matiassambrizzi/cnc-embebidos/Doc/Img/Estructura/Escuadras/resultadoFinal.JPG

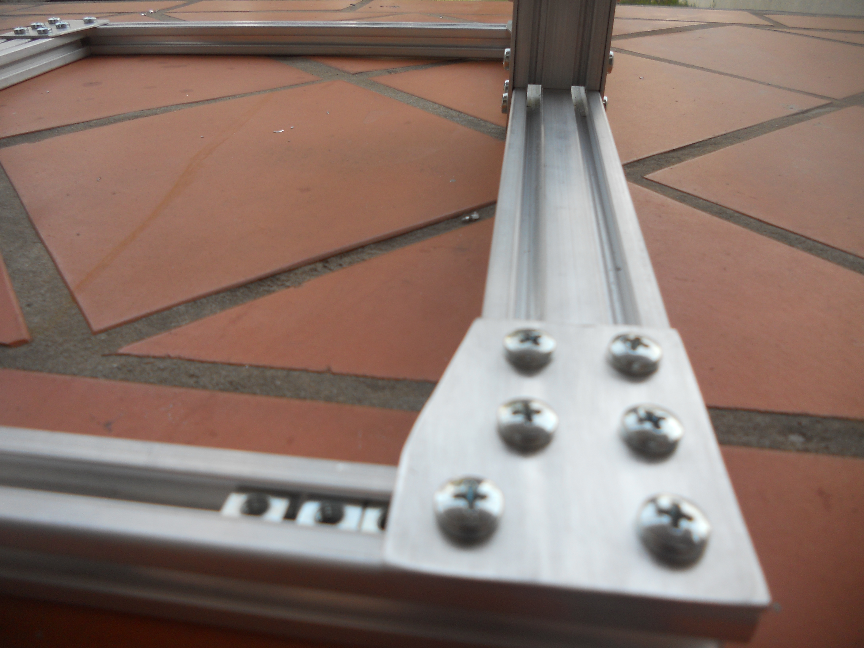
Doc/Img/Estructura/Escuadras/resultadoFinal.JPG
