matiassambrizzi/cnc-embebidos/Doc/Img/Estructura/Escuadras/resultadoFinalLateral.JPG

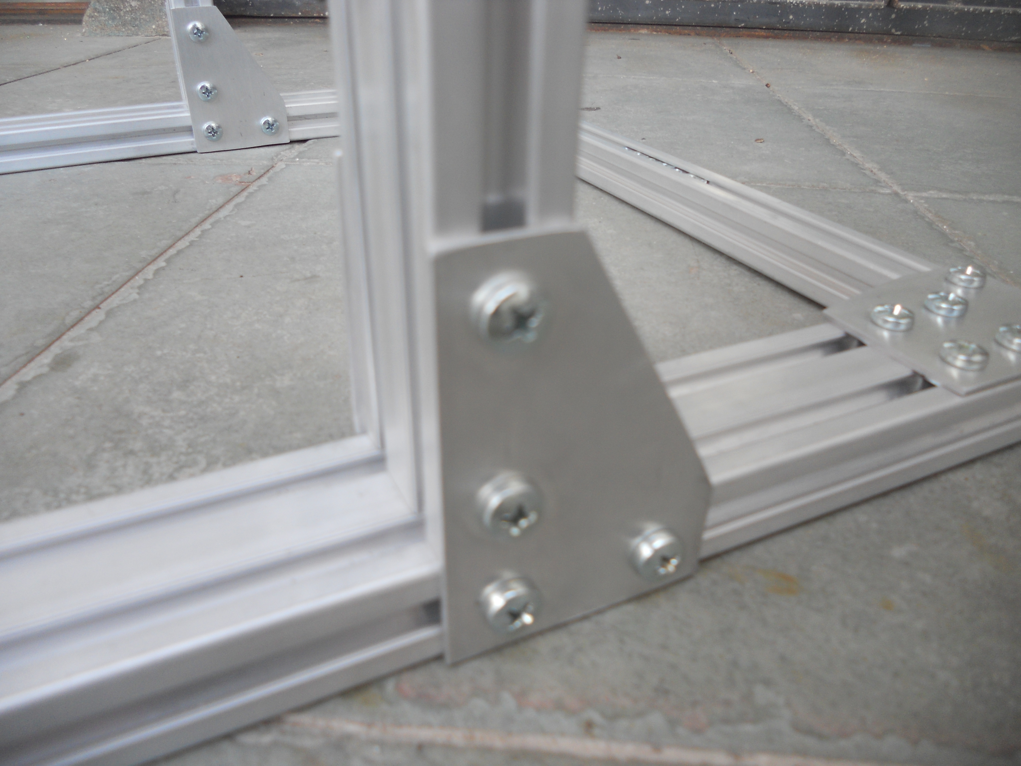
Doc/Img/Estructura/Escuadras/resultadoFinalLateral.JPG
