matiassambrizzi/cnc-embebidos/README.md

# cnc-embebidos
Construcción de una máquina CNC

> [Link a la Wiki](https://github.com/matiassambrizzi/cnc-embebidos/wiki)  
> [Link al servidor web del proyecto](https://github.com/matiassambrizzi/cnc-web-server)
