matiassambrizzi/cnc-embebidos/Datasheets/medidasAllen.jpg

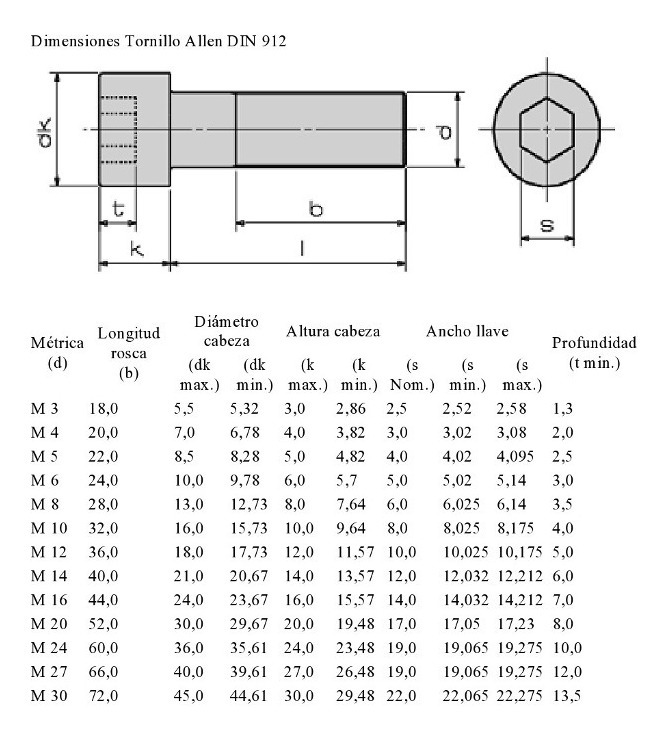
Datasheets/medidasAllen.jpg
