matiassambrizzi/cnc-embebidos/Datasheets/poleaLisaDImenisones.jpeg

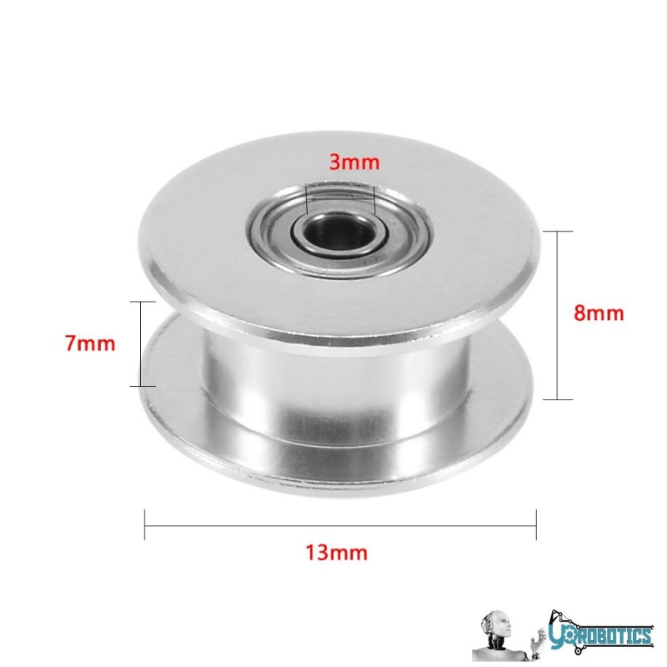
Datasheets/poleaLisaDImenisones.jpeg
