matiassambrizzi/cnc-embebidos/Datasheets/tuercasHexagonalesMedidas.jpg

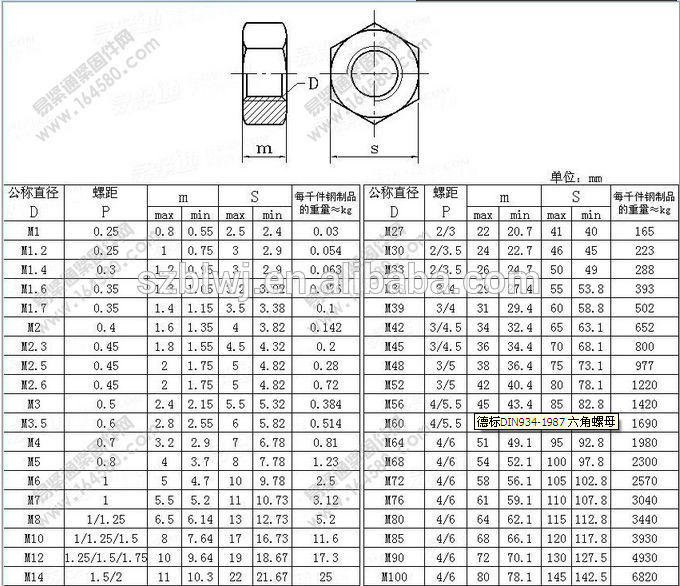
Datasheets/tuercasHexagonalesMedidas.jpg
