matiassambrizzi/cnc-embebidos/Doc/Img/dbloques.png

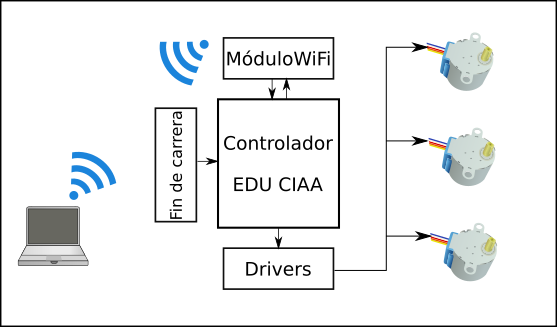
Doc/Img/dbloques.png
