matiassambrizzi/cnc-embebidos/Doc/Img/Estructura/Escuadras/haciendoAgujero.JPG

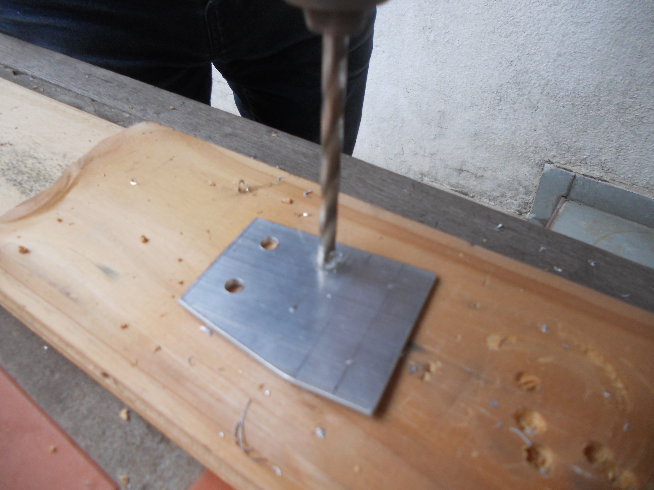
Doc/Img/Estructura/Escuadras/haciendoAgujero.JPG
