matiassambrizzi/cnc-embebidos/Doc/Img/Estructura/Escuadras/marcandoAgujeros2.JPG

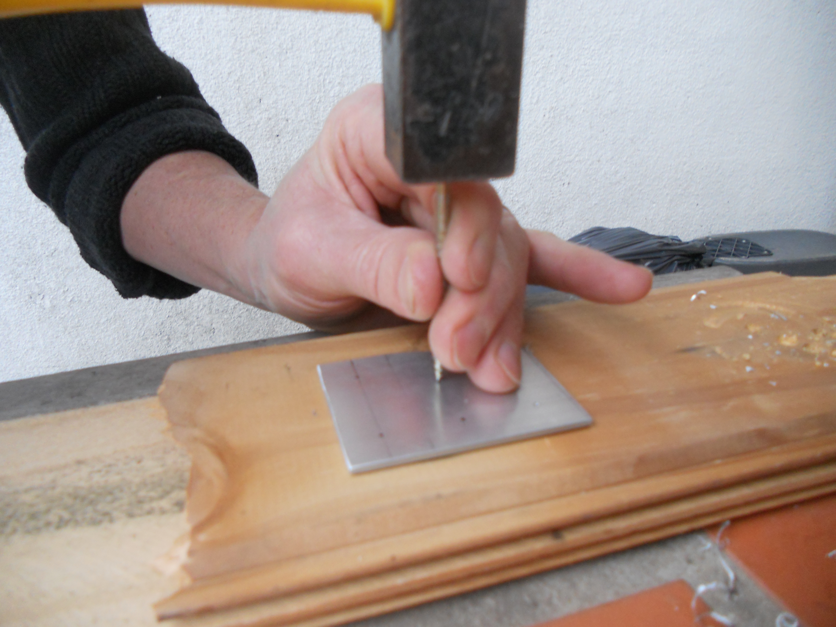
Doc/Img/Estructura/Escuadras/marcandoAgujeros2.JPG
