matiassambrizzi/cnc-embebidos/Doc/Img/Estructura/Escuadras/marcandoAgujeros.JPG

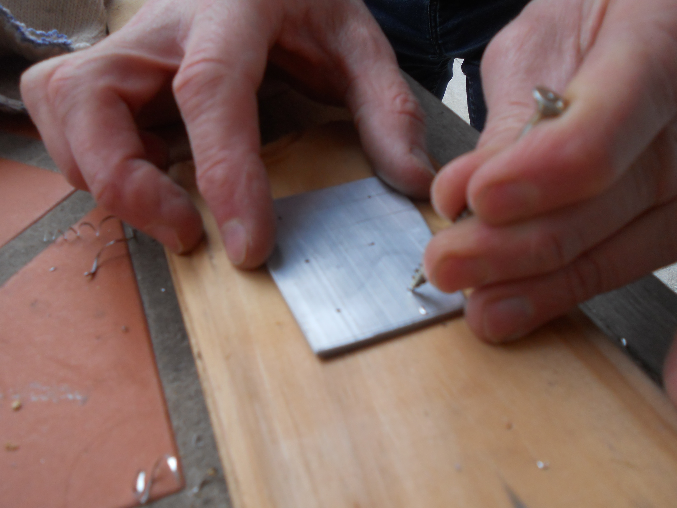
Doc/Img/Estructura/Escuadras/marcandoAgujeros.JPG
