matiassambrizzi/cnc-embebidos/Doc/Img/Gantt/gantt.png

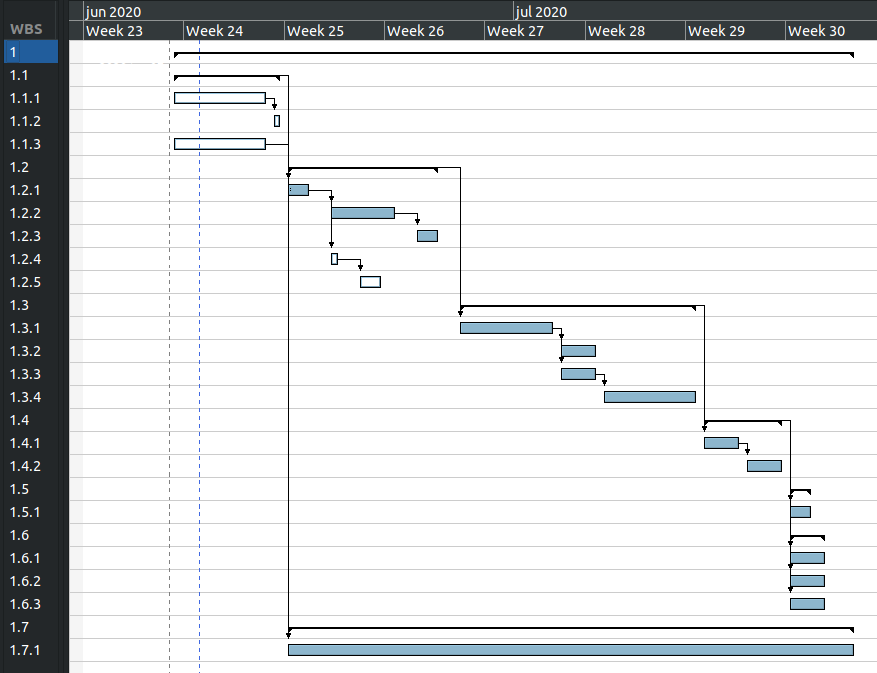
Doc/Img/Gantt/gantt.png
