matiassambrizzi/cnc-embebidos/Doc/Img/Gantt/wbs.png

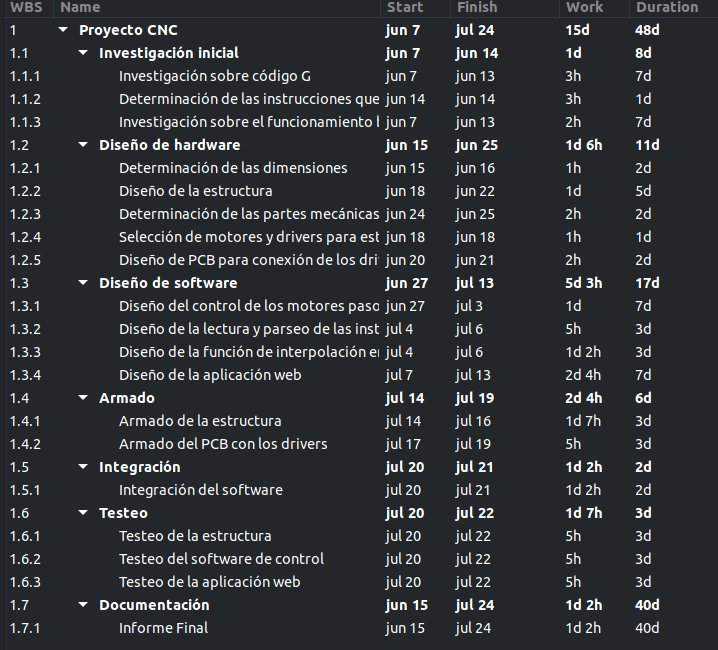
Doc/Img/Gantt/wbs.png
