matiassambrizzi/cnc-embebidos/Doc/Img/impresoraFreecad.png

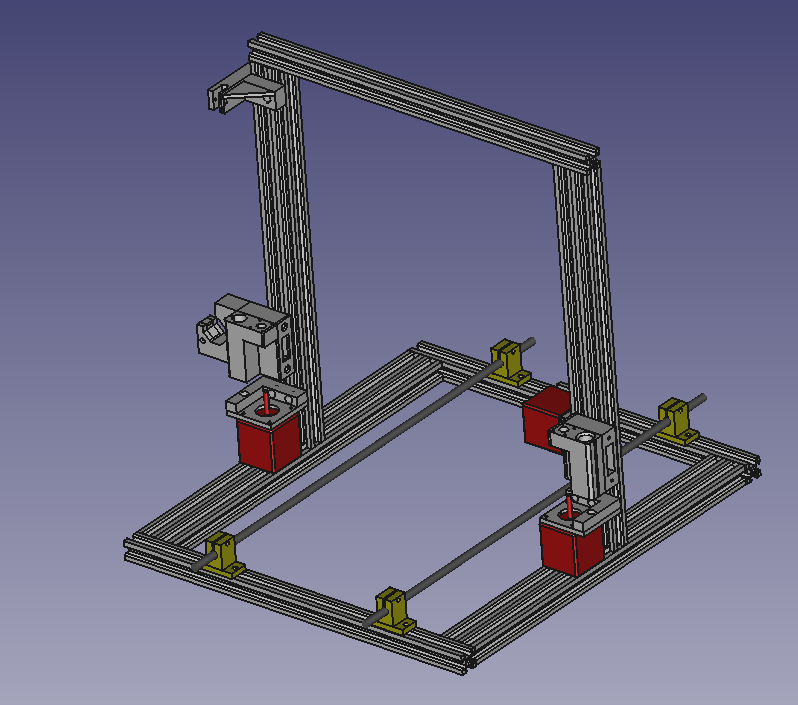
Doc/Img/impresoraFreecad.png
