matiassambrizzi/cnc-embebidos/Doc/Img/timingDiagramDriver.png

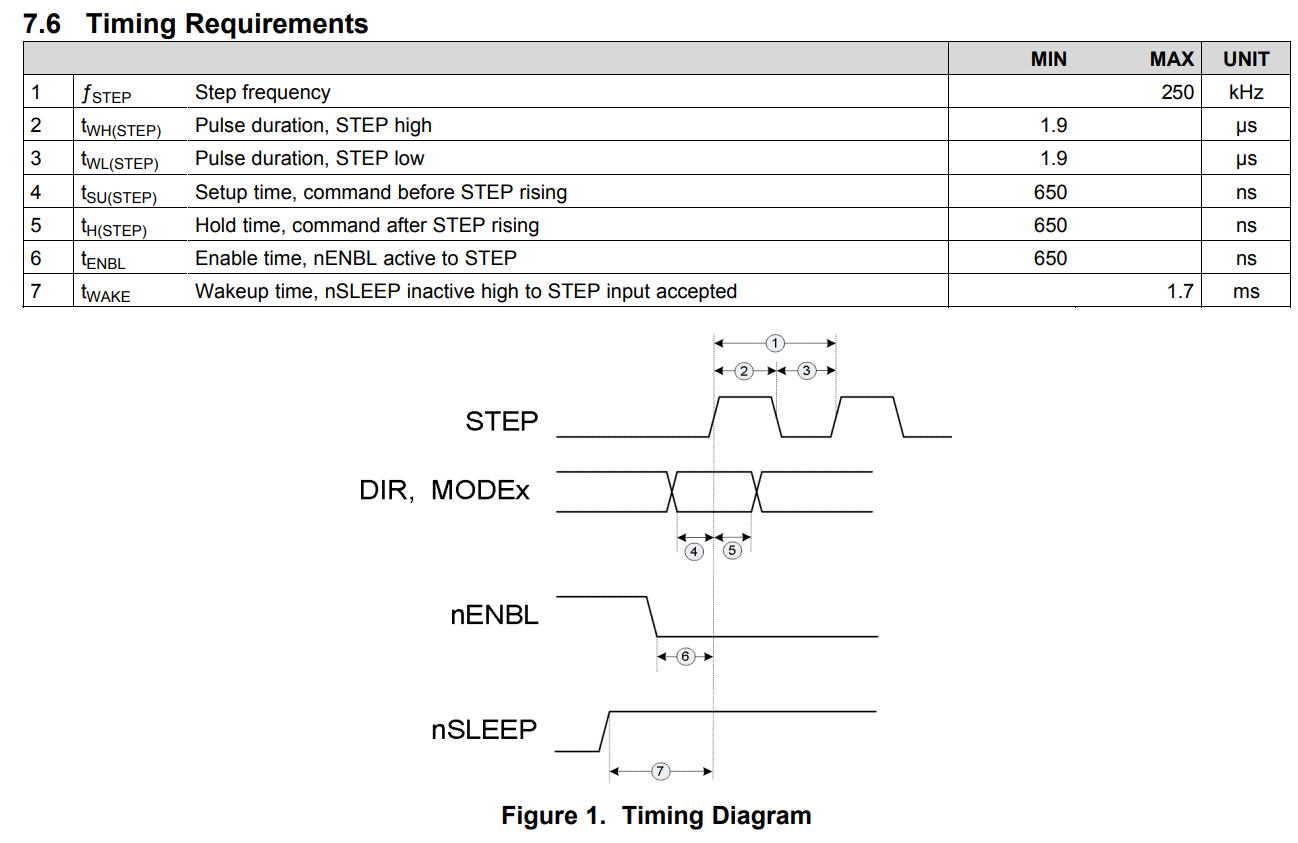
Doc/Img/timingDiagramDriver.png
