matiassambrizzi/cnc-embebidos/Modelos/impresora.FCStd

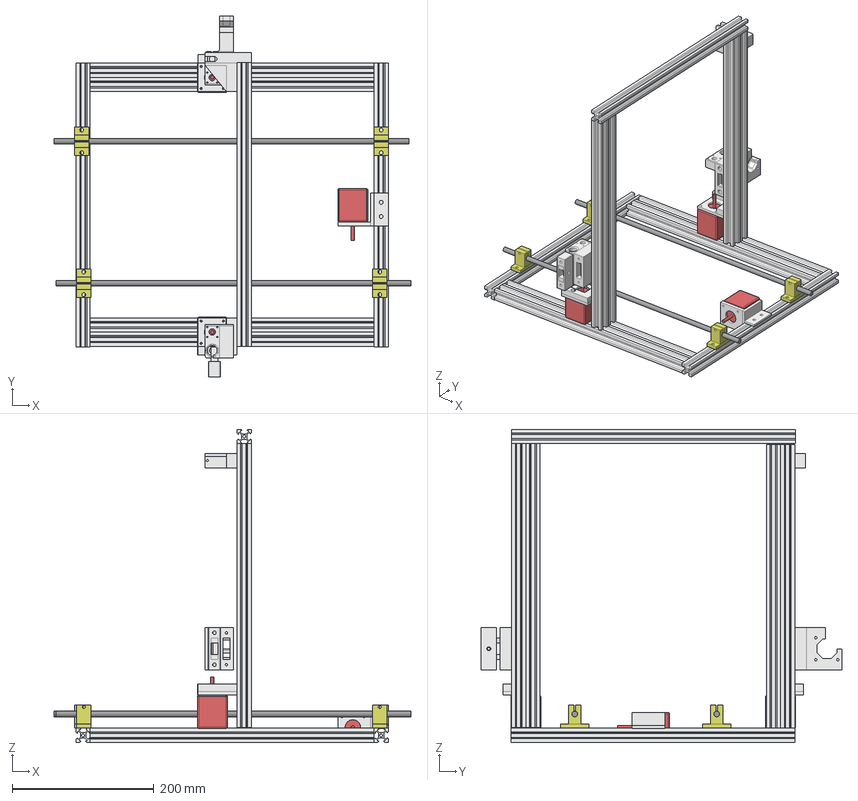
[picture p14: CAD file, 2020-07-09]
Modelos/impresora.FCStd
503.0 x 508.5 x 441.2 mm
soporteVarilla002
soporteVarilla003
soporteVarilla004
soporteVarilla001
soporteMotorNema019
varillaacero8mmEjeX2
varillaacero8mmEjeX1
MotorNmea018
MotorEjez1
MotorEjez2
soporteEjeYSinMotorDerecho001
soporteEjeYConMotorIzquierdo001
portaVarillaLisaEjezIzquierdo
