matiassambrizzi/cnc-embebidos/Test/README.md

Readme
======

Generar CodigoG con inkscape: ver este [link](https://www.ctoom.com/tutorial/how-to-create-g-code-file-with-inkscape/)
