matiassambrizzi/cnc-embebidos/TODO.md

Cosas para hacer
================

1. Agregar los fines de carrera a la cnc
1. Mejorar los códigos M
1. Movimiento circular 
1. Mejorar la aplicacion web
1. Hacer un PCB
1. Comprar hotend
1. Comprar extrusor
