matiassambrizzi/cnc-embebidos/CNC/src/motors.c

#include "motors.h"

/*
 * Estructura interna
 * ==================
 */

typedef struct {
	uint8_t step_pin;
	uint8_t dir_pin;
	uint8_t end_stop_pin;
} motor_t;

/*
 * Variables internas
 * ==================
 */

static motor_t x_motor;
static motor_t y_motor;
static motor_t z_motor;

/*
 * Prototipos funciones privadas
 * =============================
 */

// TODO


/*
 * Implementación de funciones privadas
 * ====================================
 */

static void onestep(motor_t m)
{
	gpioWrite(m.step_pin, true);
	gpioWrite(m.step_pin, false);
}

/*
 * Implementación de funciones púbicas
 * ===================================
 */

void motorInit()
{
	gpioInit(MOTOR_X_DIR, GPIO_OUTPUT);
	gpioInit(MOTOR_X_STEP, GPIO_OUTPUT);
	gpioInit(MOTOR_Y_DIR, GPIO_OUTPUT);
	gpioInit(MOTOR_Y_STEP, GPIO_OUTPUT);
	gpioInit(MOTOR_Z_DIR, GPIO_OUTPUT);
	gpioInit(MOTOR_Z_STEP, GPIO_OUTPUT);
	gpioInit(END_STOP_X, GPIO_INPUT);
}



void motor_config(uint8_t step_pin_x, uint8_t dir_pin_x, uint8_t end_stop_x,
		  uint8_t step_pin_y, uint8_t dir_pin_y, uint8_t end_stop_y,
		  uint8_t step_pin_z, uint8_t dir_pin_z, uint8_t end_stop_z)
{
	//X Motor Config
	x_motor.step_pin = step_pin_x;
	x_motor.dir_pin = dir_pin_x;
	x_motor.end_stop_pin = end_stop_x;
	//Y Motor Config
	y_motor.step_pin = step_pin_y;
	y_motor.dir_pin = dir_pin_y;
	y_motor.end_stop_pin = end_stop_y;
	//Z Motor config
	z_motor.step_pin = step_pin_z;
	z_motor.dir_pin = dir_pin_z;
	z_motor.end_stop_pin = end_stop_z;
}

void motor_x_move(uint8_t dir)
{
	gpioWrite(x_motor.dir_pin, dir);
	onestep(x_motor);
}

void motor_y_move(uint8_t dir)
{
	gpioWrite(y_motor.dir_pin, dir);
	onestep(y_motor);
}

void motor_z_move(uint8_t dir)
{
	gpioWrite(z_motor.dir_pin, dir);
	onestep(z_motor);
}


bool_t end_stop_x_is_press(void)
{
	return !gpioRead(x_motor.end_stop_pin);
}


bool_t end_stop_y_is_press(void)
{
	return !gpioRead(y_motor.end_stop_pin);
}

bool_t end_stop_z_is_press(void)
{
	return !gpioRead(z_motor.end_stop_pin);
}
