matiassambrizzi/cnc-embebidos/CNC/test/test_motion.c

#include "unity.h"
#include <math.h>
#include "motion.h"
#include "mock_test_utils.h"
#include "mock_position.h"
#include "mock_motors.h"
#include "mock_uart.h"
#include "mock_gcode.h"
#include "mock_interpolation.h"

void setUp(void)
{
}

void tearDown(void)
{
}

void test_motion_NeedToImplement(void)
{
}
