matiassambrizzi/cnc-embebidos/CNC/test/test_interpolation.c

#include "unity.h"
#include "interpolation.h"
#include "interpolation.c"
#include "mock_test_utils.h"
#include "mock_position.h"
#include "mock_motors.h"

void setUp(void)
{
}

void tearDown(void)
{
}

void test_interpolation_NeedToImplement(void)
{
}
