matiassambrizzi/cnc-embebidos/(commit log)

2020-06-09 Added DRV8825 module pin-out
2020-06-28 Added Freecad Model Printer
    [impresora.FCStd]
2020-06-28 Soportes EJEX terminados
    [impresora.FCStd]
2020-06-28 Updated Impresora
    [impresora.FCStd]
2020-07-03 Added modelo soportes ejez
    [impresora.FCStd]
2020-07-03 Finished modelos soporte motoor ejeZ
    [impresora.FCStd]
2020-07-03 Finished soporte polea lisa x axis
    [impresora.FCStd]
2020-07-03 Finished modelo soporte varilla lisa eje z
    [impresora.FCStd]
2020-07-03 All Model Finished
    [impresora.FCStd]
2020-07-03 Added Datasheets
    [impresora.FCStd]
2020-07-04 Updated Impresora
    Cambie las profundidades de algunos agujeros para que se
    correspondan con los largos de los tronillos que quiero
    comprar.
    [impresora.FCStd]
2020-07-06 Added lpc4337 Datasheet; CNC src; Motor Driver img
2020-07-06 Started read_line; process_line
    Trabajando en la conversión de string a float
2020-07-08 Updated Modelos Freecad
    [impresora.FCStd]
2020-07-08 Code Refactoring
    Added motors.h/.c:
    - En este archivo arme una estructura motor_t y definí 3 instancias
    privadas
    Added movment.c
    - Para poner las funciones de interpolación
2020-07-08 Finished Bresenham's Algorithm
    Termine de implementar y testear el algoritmo de interpolación
    lineal
2020-07-09 Updated program
    Agrego algunas estructuras
    [impresora.FCStd]
2020-07-09 Uart Task Done
2020-07-11 Added Homing_X
2020-07-11 Code working
    Ver la funcion READ_NUMBER, atof no es una buena funcion.
2020-07-11 Updated files
    Agregue la funcion ready_to_process()
    - Envia un caracter por UART para avisar que hay espacio en la cola
    para guardar caracteres
2020-07-12 Rtos Integration (#1)
    * Updated program
    * Uart Task Done
    * Working on FreeRTOS
    * Added speed_t ver
    * Added Homing_X
    * Added xQueueReset()
    * Code working
    * Finished mod, code woking
    * Updated files
    * Updated line interpolation
    Cambie algunas mutilplicaciones por shifts
    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
2020-07-13 Updated motion.h/.c
    [WIP] Aceleración de los motores
2020-07-13 Updated config.mk
    Cambie la configuración de como maneja el heap FreeRTOS
    Puse el primer modo porque en el programa no hay eliminación de tareas
2020-07-13 Updated config.h
    Agregue la configuración de la velocidad mínima y máxima
2020-07-14 Updated Project
    Le agregue la aceleracion al movimiento en linea recta
    La aceleracion se puede modificar mandando un comando por la terminal
    - $a10
    seteo al aceleracion en 10 pasos/s^{2}
2020-07-14 Rtos acceleration (#3)
    * Updated config.mk
    * Updated config.h
    * Updated FreeRTOSConfig
    * Updated Project
    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
2020-07-14 Added interpolation module
    Puse todas las funcioes y calculos que se corresponden con la
    interpolación en un modulo separado
2020-07-14 Updated motion module
    Integre el modulo de interpolacion en motion
2020-07-14 [WIP] process_line
    Hay Problemas con la función strtod y strtof:
    Cuando mando por serie un valor entre 0.0 y 0.9 lo reconoce como 0
    a menor que mande el signo, +0.0 ~ +0.9
    [process_line.c]
2020-07-18 Updated project. Started the pause task.
    Una posibilidad es hacer una tarea periodica que se fije las variables
    del sistema y de semáforos si el programa puede ejecutar movimientos.
    TODO: Ver como trabajan los counting semaphores
2020-07-19 Added UART test module
    cambie algunas cosas el el modulo del uart:
    - Agregue uan variable global count que lleva cuenta de cuandos
    elementos hay en el buffer
2020-07-19 Updated Project
    Cosas que se agregaron:
    - stringToFloat(); se testeo y se puso en el código esta función
    - coordinates_t -> Relativo o absoluto
    - G92 -> Set pos as origin
2020-07-19 Updater stringToFloat()
    Arregle el bug de la ','
    [process_line.c, test_process_line.c, uart.h]
2020-07-23 agregue el valor de steps per mm para x, y, z
    El valor de Z lo tengo que ver porque la varilla no es de 1mm por vuelta
2020-07-24 Updated project
    - Modifique los pasos por milimetro para cada eje
    - Empece a ver como andan los motores con microstepping
    - [WIP] Posicionamiento relativo
2020-07-26 Updated project
    Falta calibrar steps/mm del ejez
    Estoy probando distitnas configuraciones de corriente y microstepping
2020-07-26 Updated config.h
    Calibre mejor el ejeZ
